jstein91/Apex/Apex rev1.kicad_pcb

## KiCad design Apex rev1.kicad_pcb (2020-07-08)

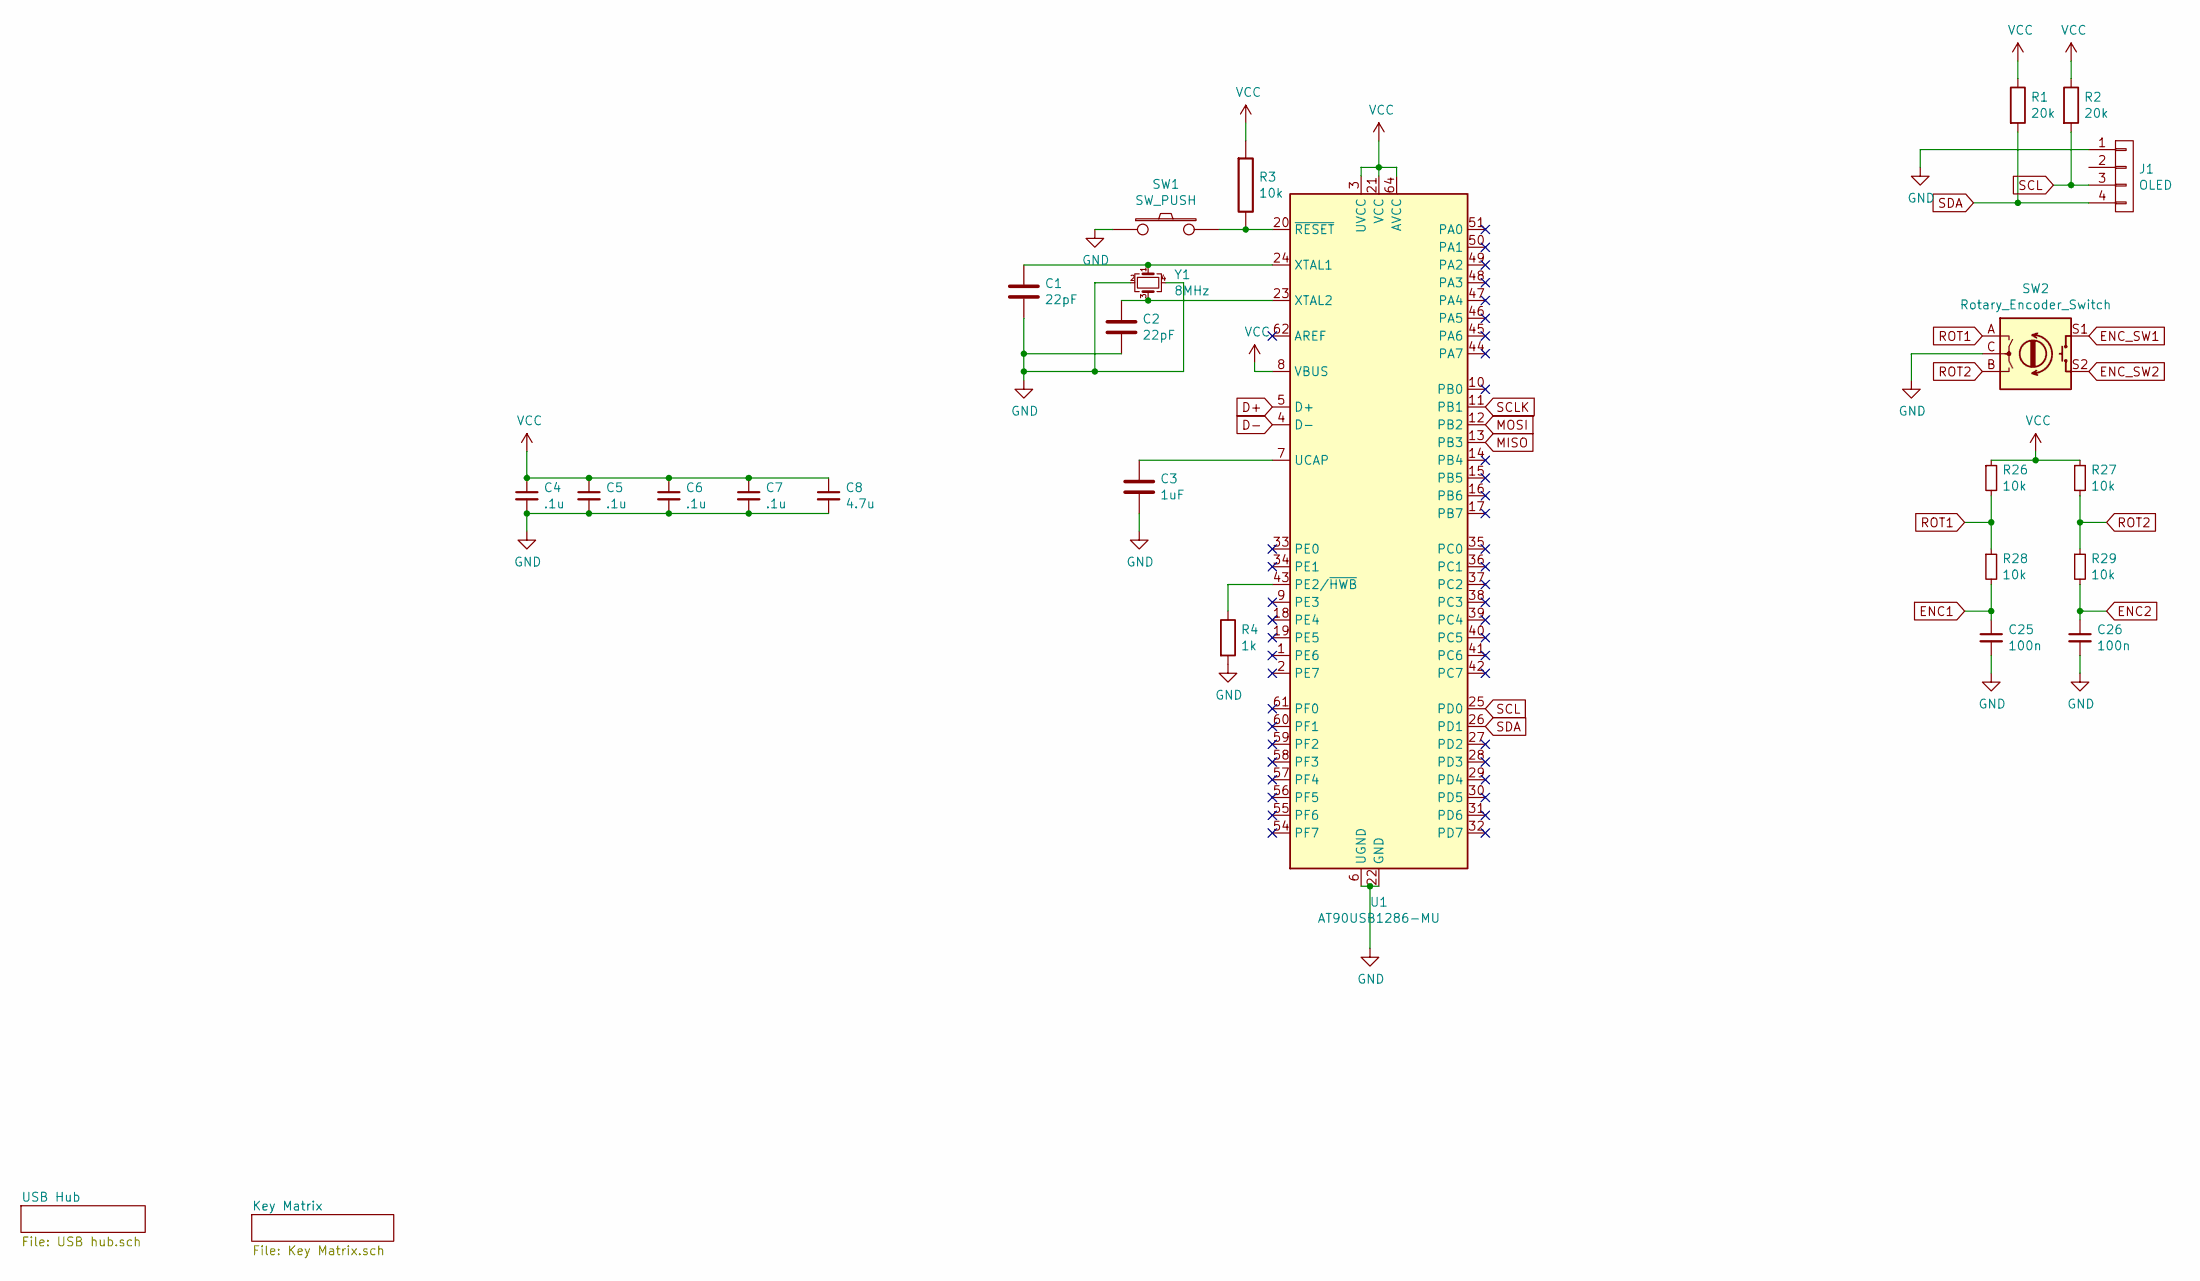
[picture p1: schematic Apex rev1.sch]

Parts:
C1, C2: 22pF; C_0805_2012Metric
C3: 1uF; C_0805_2012Metric
C4, C5, C6, C7: .1u; C_0805_2012Metric
C8: 4.7u; C_0805_2012Metric
C25, C26: 100n; C_0805_2012Metric
J1: OLED; 128X32_I2C_OLED
R1, R2: 20k; R_0603
R3, R26, R27, R28, R29: 10k; R_0603
R4: 1k; R_0603
SW1: SW_PUSH; SKQG-1155865
SW2: Rotary_Encoder_Switch; RotaryEncoder_EC11
U1: AT90USB1286-MU; QFN-64-1EP_9x9mm_P0.5mm_EP7.5x7.5mm
Y1: 8MHz; Crystal_SMD_3225-4Pin_3.2x2.5mm

Connections:
D+: U1.5 (D+); also elsewhere on the board
D-: U1.4 (D-); also elsewhere on the board
ENC1: C25.1, R28.2
ENC2: C26.1, R29.2
ENC_SW1: SW2.S1
ENC_SW2: SW2.S2
GND: C1.2, C2.2, C3.2, C4.2, C5.2, C6.2, C7.2, C8.2, C25.2, C26.2, J1.1, R4.2, SW1.1, SW2.C, U1.6 (UGND), U1.22 (GND), U1.53 (GND), U1.63 (GND), U1.65 (GND), Y1.2, Y1.4; also elsewhere on the board
MISO: U1.13 (PB3)
MOSI: U1.12 (PB2)
unnamed: C1.1, U1.24 (XTAL1), Y1.1
unnamed: C2.1, U1.23 (XTAL2), Y1.3
unnamed: C3.1, U1.7 (UCAP)
unnamed: R3.2, SW1.2, U1.20 (~RESET)
unnamed: R4.1, U1.43 (PE2/~HWB)
ROT1: R26.2, R28.1, SW2.A
ROT2: R27.2, R29.1, SW2.B
SCL: J1.3, R2.2, U1.25 (PD0)
SCLK: U1.11 (PB1)
SDA: J1.4, R1.2, U1.26 (PD1)
VCC: C4.1, C5.1, C6.1, C7.1, C8.1, R1.1, R2.1, R3.1, R26.1, R27.1, U1.3 (UVCC), U1.8 (VBUS), U1.21 (VCC), U1.52 (VCC), U1.64 (AVCC); also elsewhere on the board

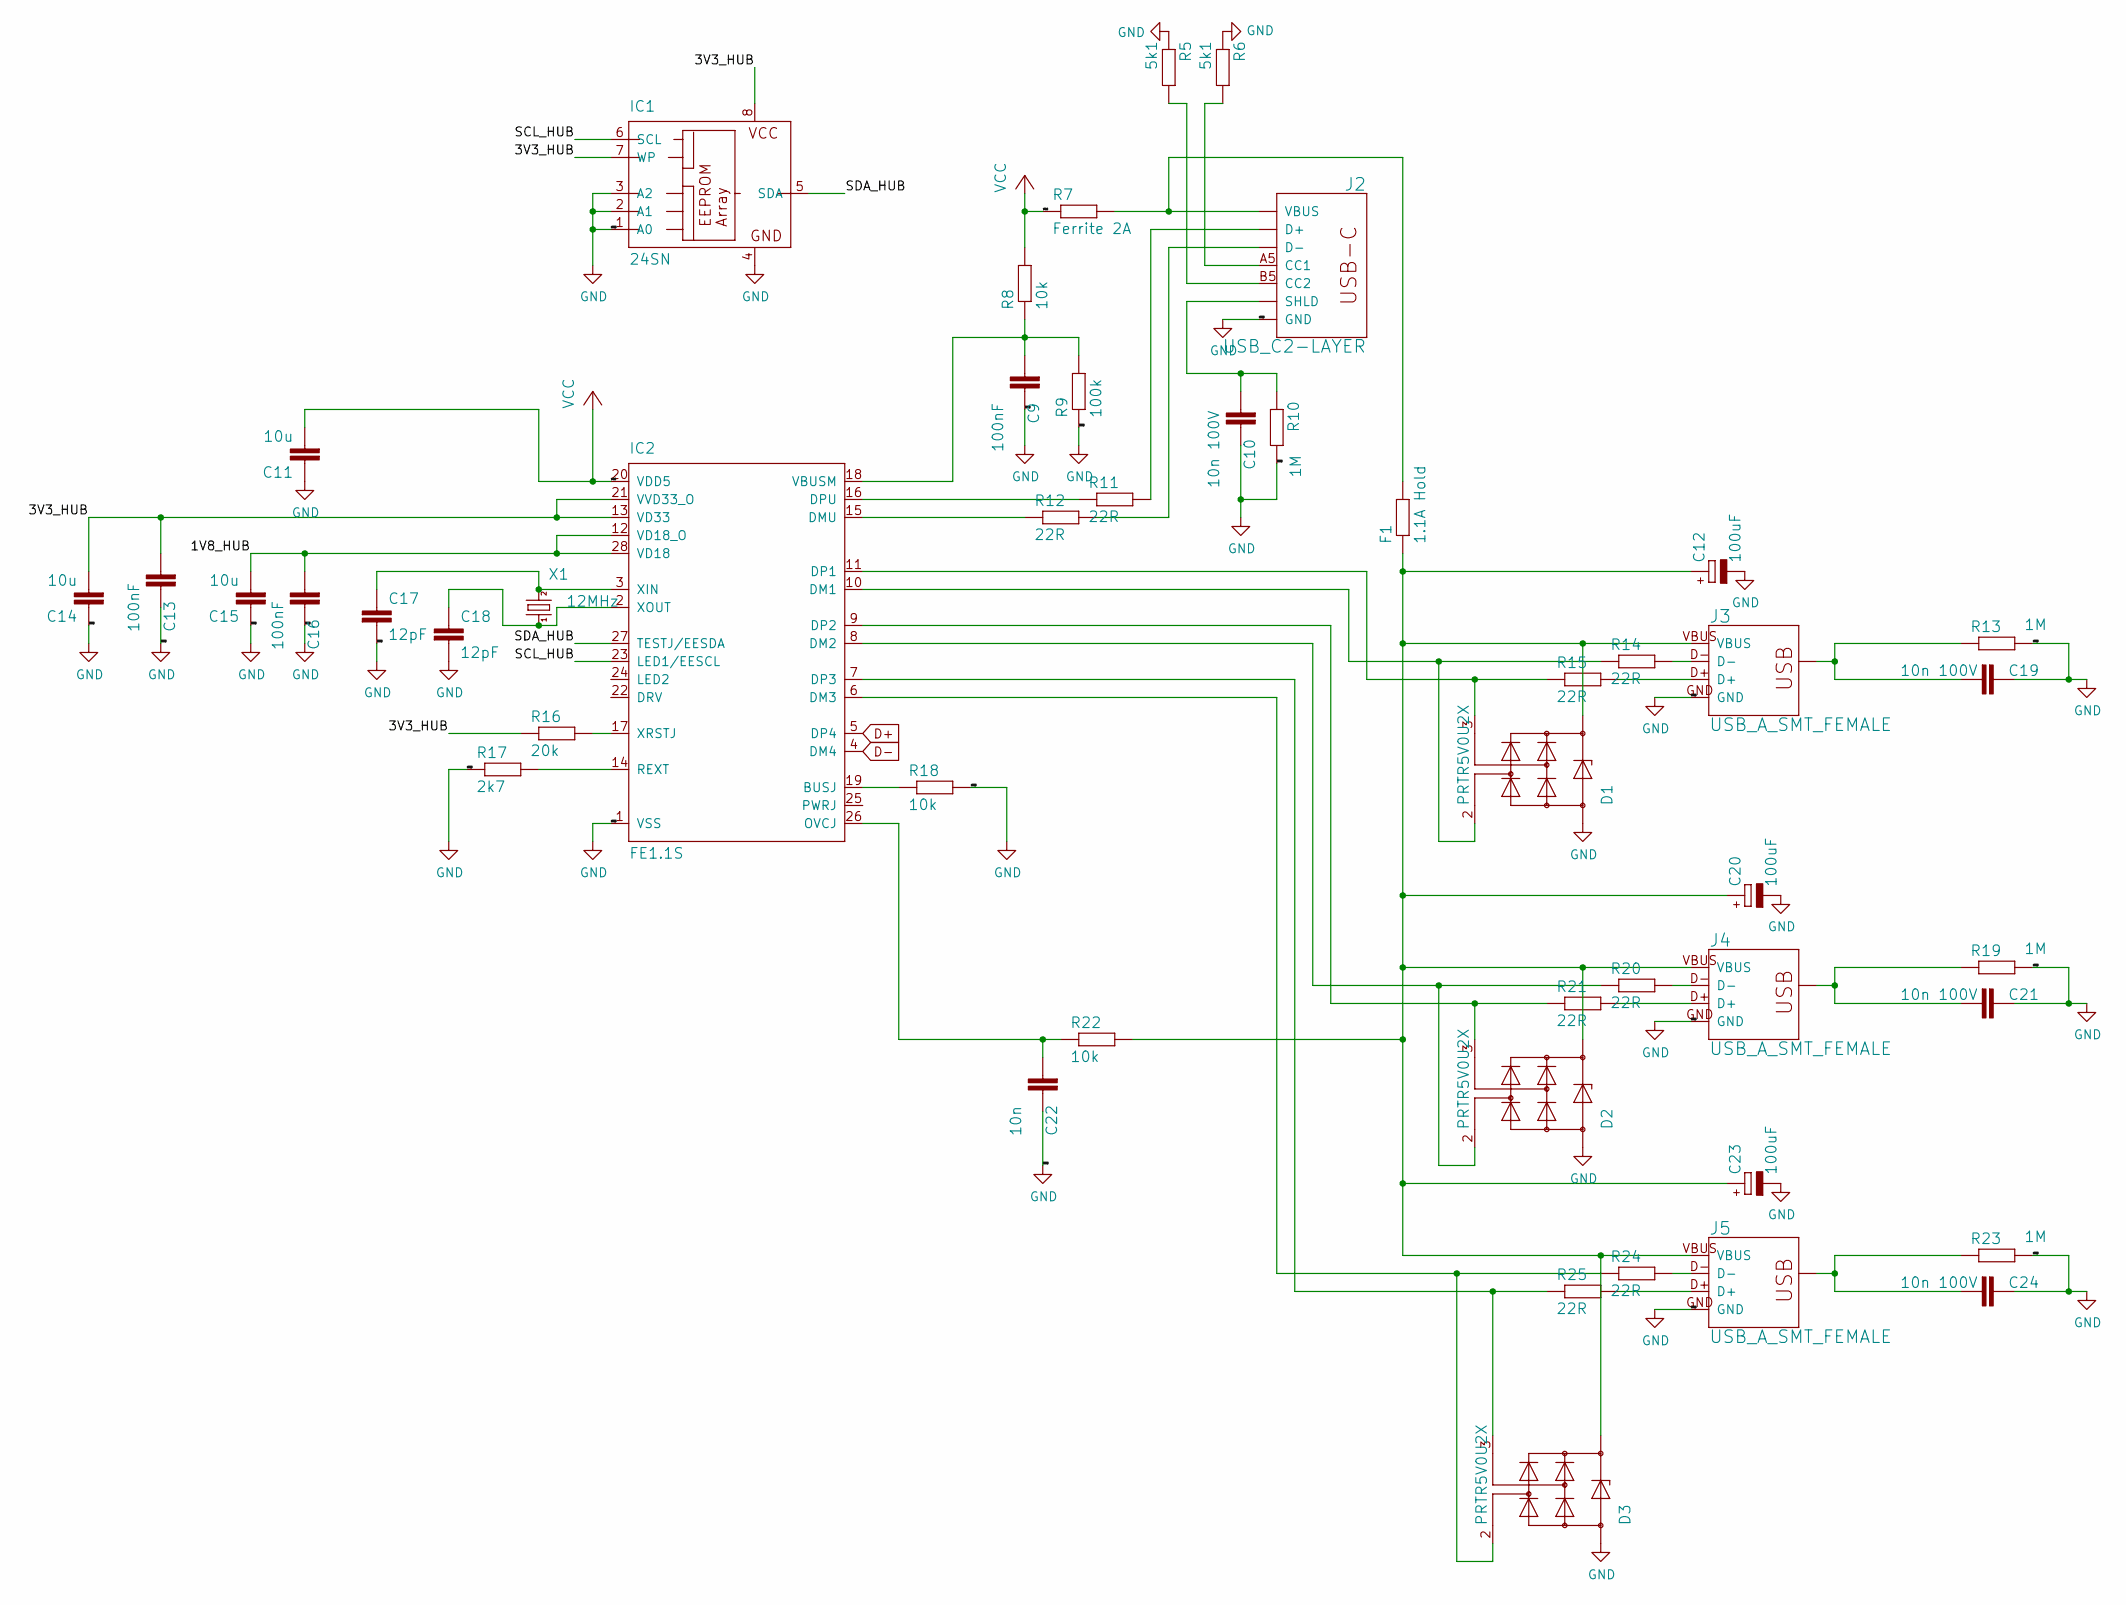
[picture p2: schematic USB hub.sch]

Parts:
C9, C13, C16: 100nF; C_0805_2012Metric; LCSC C14663
C10, C19, C21, C24: 10n 100V; C_0805_2012Metric; LCSC C84709
C11, C14, C15: 10u; C_0805_2012Metric; LCSC C19702
C12, C20, C23: 100uF; CT3528; LCSC C16133
C17, C18: 12pF; C_0805_2012Metric; LCSC C38523
C22: 10n; C_0805_2012Metric; LCSC C57112
D1, D2, D3: PRTR5V0U2X; SOT143; DIGIKEY 1727-3884-1-ND
F1: 1.1A Hold; Fuse_1206_3216Metric; LCSC C70100
IC1: 24SN; SO-08; LCSC C184083
IC2: FE1.1S; SSOP28; LCSC C9359
J2: USB_C2-LAYER; USB-C-16P; DIGIKEY 2073-USB4105-GF-ACT-ND
J3, J4, J5: USB_A_SMT_FEMALE; USB-A-S-SILK-FEMALE; DIGIKEY 609-4946-1-ND
R5, R6: 5k1; R_0603; LCSC C23186
R7: Ferrite 2A; R0805; LCSC C44361
R8, R18, R22: 10k; R_0603; LCSC C25804
R9: 100k; R_0603; LCSC C25803
R10, R13, R19, R23: 1M; R_0603; LCSC C22935
R11, R12, R14, R15, R20, R21, R24, R25: 22R; R_0603; LCSC C23345
R16: 20k; R_0603; LCSC C4184
R17: 2k7; R_0603; LCSC C13167
X1: 12MHz; Crystal_SMD_3225-4Pin_3.2x2.5mm; LCSC C9002

Connections:
/USB Hub/1V8_HUB: C15.2, C16.2, IC2.12 (VD18_O), IC2.28 (VD18)
/USB Hub/3V3_HUB: C13.2, C14.2, IC1.7 (WP), IC1.8 (VCC), IC2.13 (VD33), IC2.21 (VVD33_O), R16.1
/USB Hub/SCL_HUB: IC1.6 (SCL), IC2.23 (LED1/EESCL)
/USB Hub/SDA_HUB: IC1.5 (SDA), IC2.27 (TESTJ/EESDA)
D+: IC2.5 (DP4); also elsewhere on the board
D-: IC2.4 (DM4); also elsewhere on the board
GND: C9.1, C10.1, C11.1, C12.-, C13.1, C14.1, C15.1, C16.1, C17.2, C18.2, C19.1, C20.-, C21.1, C22.1, C23.-, C24.1, D1.1 (GND), D2.1 (GND), D3.1 (GND), IC1.1 (A0), IC1.2 (A1), IC1.3 (A2), IC1.4 (GND), IC2.1 (VSS), J2.GND, J2.GND2 (GND), J3.GND, J4.GND, J5.GND, R5.1, R6.1, R9.1, R10.2, R13.2, R17.1, R18.2, R19.2, R23.2; also elsewhere on the board
unnamed: C9.2, IC2.18 (VBUSM), R8.1, R9.2
unnamed: C10.2, J2.SHLD1 (SHLD), J2.SHLD2 (SHLD), J2.SHLD3 (SHLD), J2.SHLD4 (SHLD), J2.SHLD5 (SHLD), J2.SHLD6 (SHLD), J2.SHLD7 (SHLD), J2.SHLD8 (SHLD), R10.1
unnamed: C12.+, C20.+, C23.+, D1.4 (VCC), D2.4 (VCC), D3.4 (VCC), F1.1, J3.VBUS, J4.VBUS, J5.VBUS, R22.2
unnamed: C17.1, IC2.3 (XIN), X1.3 (2)
unnamed: C18.1, IC2.2 (XOUT), X1.1
unnamed: C19.2, J3.SHLD1 (SHIELD), J3.SHLD2 (SHIELD), R13.1
unnamed: C21.2, J4.SHLD1 (SHIELD), J4.SHLD2 (SHIELD), R19.1
unnamed: C22.2, IC2.26 (OVCJ), R22.1
unnamed: C24.2, J5.SHLD1 (SHIELD), J5.SHLD2 (SHIELD), R23.1
unnamed: D1.2 (IO1), IC2.10 (DM1), R14.1
unnamed: D1.3 (IO2), IC2.11 (DP1), R15.1
unnamed: D2.2 (IO1), IC2.8 (DM2), R20.1
unnamed: D2.3 (IO2), IC2.9 (DP2), R21.1
unnamed: D3.2 (IO1), IC2.6 (DM3), R24.1
unnamed: D3.3 (IO2), IC2.7 (DP3), R25.1
unnamed: F1.2, J2.VBUS1 (VBUS), J2.VBUS2 (VBUS), R7.2
unnamed: IC2.14 (REXT), R17.2
unnamed: IC2.15 (DMU), R12.1
unnamed: IC2.16 (DPU), R11.1
unnamed: IC2.17 (XRSTJ), R16.2
unnamed: IC2.19 (BUSJ), R18.1
unnamed: J2.A5 (CC1), R6.2
unnamed: J2.A6 (D+), J2.B6 (D+), R11.2
unnamed: J2.A7 (D-), J2.B7 (D-), R12.2
unnamed: J2.B5 (CC2), R5.2
unnamed: J3.D+, R15.2
unnamed: J3.D-, R14.2
unnamed: J4.D+, R21.2
unnamed: J4.D-, R20.2
unnamed: J5.D+, R25.2
unnamed: J5.D-, R24.2
VCC: C11.2, IC2.20 (VDD5), R7.1, R8.2; also elsewhere on the board

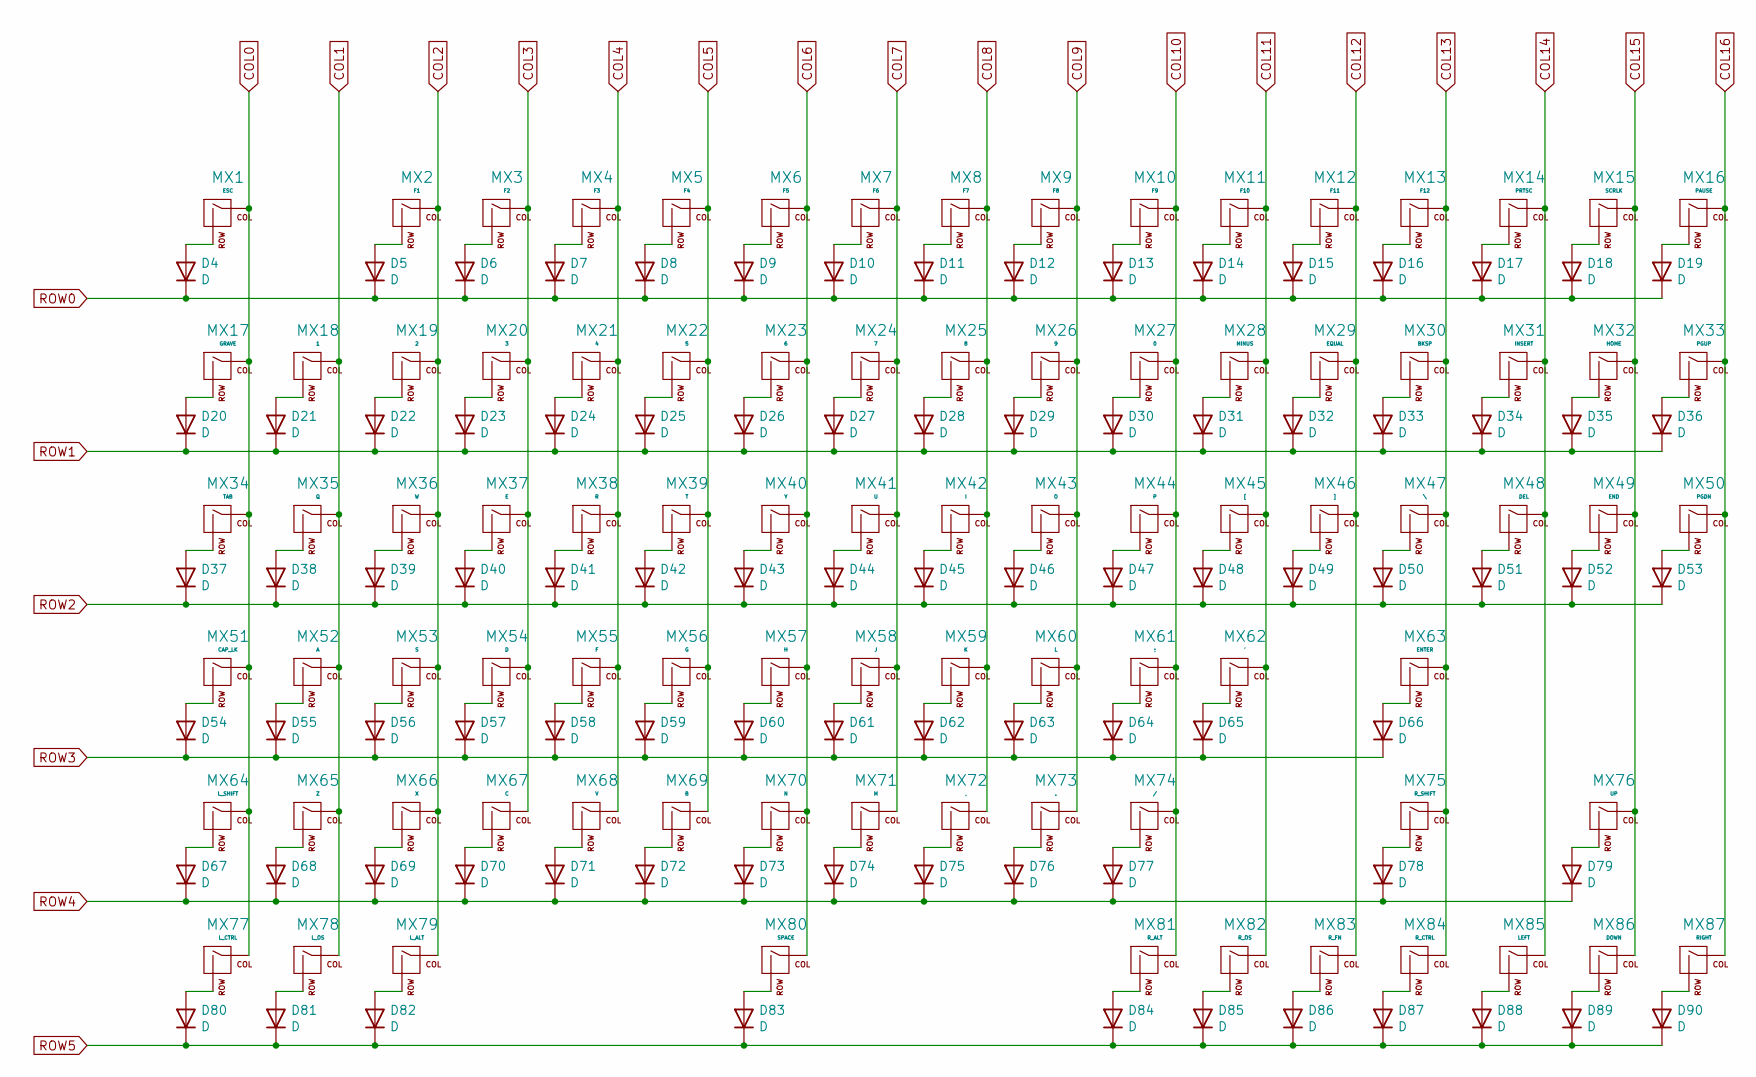
[picture p3: schematic Key Matrix.sch]

Parts:
D4, D5, D6, D7, D8, D9, D10, D11, D12, D13, D14, D15, D16, D17, D18, D19, D20, D21, D22, D23, D24, D25, D26, D27, D28, D29, D30, D31, D32, D33, D34, D35, D36, D37, D38, D39, D40, D41, D42, D43, D44, D45, D46, D47, D48, D49, D50, D51, D52, D53, D54, D55, D56, D57, D58, D59, D60, D61, D62, D63, D64, D65, D66, D67, D68, D69, D70, D71, D72, D73, D74, D75, D76, D77, D78, D79, D80, D81, D82, D83, D84, D85, D86, D87, D88, D89, D90: D; D_SOD-123
MX1: ESC; MXOnly-1U-Hotswap
MX2: F1; MXOnly-1U-Hotswap
MX3: F2; MXOnly-1U-Hotswap
MX4: F3; MXOnly-1U-Hotswap
MX5: F4; MXOnly-1U-Hotswap
MX6: F5; MXOnly-1U-Hotswap
MX7: F6; MXOnly-1U-Hotswap
MX8: F7; MXOnly-1U-Hotswap
MX9: F8; MXOnly-1U-Hotswap
MX10: F9; MXOnly-1U-Hotswap
MX11: F10; MXOnly-1U-Hotswap
MX12: F11; MXOnly-1U-Hotswap
MX13: F12; MXOnly-1U-Hotswap
MX14: PRTSC; MXOnly-1U-Hotswap
MX15: SCRLK; MXOnly-1U-Hotswap
MX16: PAUSE; MXOnly-1U-Hotswap
MX17: GRAVE; MXOnly-1U-Hotswap
MX18: 1; MXOnly-1U-Hotswap
MX19: 2; MXOnly-1U-Hotswap
MX20: 3; MXOnly-1U-Hotswap
MX21: 4; MXOnly-1U-Hotswap
MX22: 5; MXOnly-1U-Hotswap
MX23: 6; MXOnly-1U-Hotswap
MX24: 7; MXOnly-1U-Hotswap
MX25: 8; MXOnly-1U-Hotswap
MX26: 9; MXOnly-1U-Hotswap
MX27: 0; MXOnly-1U-Hotswap
MX28: MINUS; MXOnly-1U-Hotswap
MX29: EQUAL; MXOnly-1U-Hotswap
MX30: BKSP; MXOnly-2U-Hotswap
MX31: INSERT; MXOnly-1U-Hotswap
MX32: HOME; MXOnly-1U-Hotswap
MX33: PGUP; MXOnly-1U-Hotswap
MX34: TAB; MXOnly-1.5U-Hotswap
MX35: Q; MXOnly-1U-Hotswap
MX36: W; MXOnly-1U-Hotswap
MX37: E; MXOnly-1U-Hotswap
MX38: R; MXOnly-1U-Hotswap
MX39: T; MXOnly-1U-Hotswap
MX40: Y; MXOnly-1U-Hotswap
MX41: U; MXOnly-1U-Hotswap
MX42: I; MXOnly-1U-Hotswap
MX43: O; MXOnly-1U-Hotswap
MX44: P; MXOnly-1U-Hotswap
MX45: [; MXOnly-1U-Hotswap
MX46: ]; MXOnly-1U-Hotswap
MX47: \\; MXOnly-1.5U-Hotswap
MX48: DEL; MXOnly-1U-Hotswap
MX49: END; MXOnly-1U-Hotswap
MX50: PGDN; MXOnly-1U-Hotswap
MX51: CAP_LK; MXOnly-1.75U-Hotswap
MX52: A; MXOnly-1U-Hotswap
MX53: S; MXOnly-1U-Hotswap
MX54: D; MXOnly-1U-Hotswap
MX55: F; MXOnly-1U-Hotswap
MX56: G; MXOnly-1U-Hotswap
MX57: H; MXOnly-1U-Hotswap
MX58: J; MXOnly-1U-Hotswap
MX59: K; MXOnly-1U-Hotswap
MX60: L; MXOnly-1U-Hotswap
MX61: ;; MXOnly-1U-Hotswap
MX62: '; MXOnly-1U-Hotswap
MX63: ENTER; MXOnly-2.25U-Hotswap
MX64: L_SHIFT; MXOnly-2.25U-Hotswap
MX65: Z; MXOnly-1U-Hotswap
MX66: X; MXOnly-1U-Hotswap
MX67: C; MXOnly-1U-Hotswap
MX68: V; MXOnly-1U-Hotswap
MX69: B; MXOnly-1U-Hotswap
MX70: N; MXOnly-1U-Hotswap
MX71: M; MXOnly-1U-Hotswap
MX72: ,; MXOnly-1U-Hotswap
MX73: .; MXOnly-1U-Hotswap
MX74: /; MXOnly-1U-Hotswap
MX75: R_SHIFT; MXOnly-2.75U-Hotswap
MX76: UP; MXOnly-1U-Hotswap
MX77: L_CTRL; MXOnly-1.25U-Hotswap
MX78: L_OS; MXOnly-1.25U-Hotswap
MX79: L_ALT; MXOnly-1.25U-Hotswap
MX80: SPACE; MXOnly-6.25U-Hotswap
MX81: R_ALT; MXOnly-1.25U-Hotswap
MX82: R_OS; MXOnly-1.25U-Hotswap
MX83: R_FN; MXOnly-1.25U-Hotswap
MX84: R_CTRL; MXOnly-1.25U-Hotswap
MX85: LEFT; MXOnly-1U-Hotswap
MX86: DOWN; MXOnly-1U-Hotswap
MX87: RIGHT; MXOnly-1U-Hotswap

Connections:
COL0: MX1.1 (COL), MX17.1 (COL), MX34.1 (COL), MX51.1 (COL), MX64.1 (COL), MX77.1 (COL)
COL1: MX18.1 (COL), MX35.1 (COL), MX52.1 (COL), MX65.1 (COL), MX78.1 (COL)
COL2: MX2.1 (COL), MX19.1 (COL), MX36.1 (COL), MX53.1 (COL), MX66.1 (COL), MX79.1 (COL)
COL3: MX3.1 (COL), MX20.1 (COL), MX37.1 (COL), MX54.1 (COL), MX67.1 (COL)
COL4: MX4.1 (COL), MX21.1 (COL), MX38.1 (COL), MX55.1 (COL), MX68.1 (COL)
COL5: MX5.1 (COL), MX22.1 (COL), MX39.1 (COL), MX56.1 (COL), MX69.1 (COL)
COL6: MX6.1 (COL), MX23.1 (COL), MX40.1 (COL), MX57.1 (COL), MX70.1 (COL), MX80.1 (COL)
COL7: MX7.1 (COL), MX24.1 (COL), MX41.1 (COL), MX58.1 (COL), MX71.1 (COL)
COL8: MX8.1 (COL), MX25.1 (COL), MX42.1 (COL), MX59.1 (COL), MX72.1 (COL)
COL9: MX9.1 (COL), MX26.1 (COL), MX43.1 (COL), MX60.1 (COL), MX73.1 (COL)
COL10: MX10.1 (COL), MX27.1 (COL), MX44.1 (COL), MX61.1 (COL), MX74.1 (COL), MX81.1 (COL)
COL11: MX11.1 (COL), MX28.1 (COL), MX45.1 (COL), MX62.1 (COL), MX82.1 (COL)
COL12: MX12.1 (COL), MX29.1 (COL), MX46.1 (COL), MX83.1 (COL)
COL13: MX13.1 (COL), MX30.1 (COL), MX47.1 (COL), MX63.1 (COL), MX75.1 (COL), MX84.1 (COL)
COL14: MX14.1 (COL), MX31.1 (COL), MX48.1 (COL), MX85.1 (COL)
COL15: MX15.1 (COL), MX32.1 (COL), MX49.1 (COL), MX76.1 (COL), MX86.1 (COL)
COL16: MX16.1 (COL), MX33.1 (COL), MX50.1 (COL), MX87.1 (COL)
unnamed: D4.2 (A), MX1.2 (ROW)
unnamed: D5.2 (A), MX2.2 (ROW)
unnamed: D6.2 (A), MX3.2 (ROW)
unnamed: D7.2 (A), MX4.2 (ROW)
unnamed: D8.2 (A), MX5.2 (ROW)
unnamed: D9.2 (A), MX6.2 (ROW)
unnamed: D10.2 (A), MX7.2 (ROW)
unnamed: D11.2 (A), MX8.2 (ROW)
unnamed: D12.2 (A), MX9.2 (ROW)
unnamed: D13.2 (A), MX10.2 (ROW)
unnamed: D14.2 (A), MX11.2 (ROW)
unnamed: D15.2 (A), MX12.2 (ROW)
unnamed: D16.2 (A), MX13.2 (ROW)
unnamed: D17.2 (A), MX14.2 (ROW)
unnamed: D18.2 (A), MX15.2 (ROW)
unnamed: D19.2 (A), MX16.2 (ROW)
unnamed: D20.2 (A), MX17.2 (ROW)
unnamed: D21.2 (A), MX18.2 (ROW)
unnamed: D22.2 (A), MX19.2 (ROW)
unnamed: D23.2 (A), MX20.2 (ROW)
unnamed: D24.2 (A), MX21.2 (ROW)
unnamed: D25.2 (A), MX22.2 (ROW)
unnamed: D26.2 (A), MX23.2 (ROW)
unnamed: D27.2 (A), MX24.2 (ROW)
unnamed: D28.2 (A), MX25.2 (ROW)
unnamed: D29.2 (A), MX26.2 (ROW)
unnamed: D30.2 (A), MX27.2 (ROW)
unnamed: D31.2 (A), MX28.2 (ROW)
unnamed: D32.2 (A), MX29.2 (ROW)
unnamed: D33.2 (A), MX30.2 (ROW)
unnamed: D34.2 (A), MX31.2 (ROW)
unnamed: D35.2 (A), MX32.2 (ROW)
unnamed: D36.2 (A), MX33.2 (ROW)
unnamed: D37.2 (A), MX34.2 (ROW)
unnamed: D38.2 (A), MX35.2 (ROW)
unnamed: D39.2 (A), MX36.2 (ROW)
unnamed: D40.2 (A), MX37.2 (ROW)
unnamed: D41.2 (A), MX38.2 (ROW)
unnamed: D42.2 (A), MX39.2 (ROW)
unnamed: D43.2 (A), MX40.2 (ROW)
unnamed: D44.2 (A), MX41.2 (ROW)
unnamed: D45.2 (A), MX42.2 (ROW)
unnamed: D46.2 (A), MX43.2 (ROW)
unnamed: D47.2 (A), MX44.2 (ROW)
unnamed: D48.2 (A), MX45.2 (ROW)
unnamed: D49.2 (A), MX46.2 (ROW)
unnamed: D50.2 (A), MX47.2 (ROW)
unnamed: D51.2 (A), MX48.2 (ROW)
unnamed: D52.2 (A), MX49.2 (ROW)
unnamed: D53.2 (A), MX50.2 (ROW)
unnamed: D54.2 (A), MX51.2 (ROW)
unnamed: D55.2 (A), MX52.2 (ROW)
unnamed: D56.2 (A), MX53.2 (ROW)
unnamed: D57.2 (A), MX54.2 (ROW)
unnamed: D58.2 (A), MX55.2 (ROW)
unnamed: D59.2 (A), MX56.2 (ROW)
unnamed: D60.2 (A), MX57.2 (ROW)
unnamed: D61.2 (A), MX58.2 (ROW)
unnamed: D62.2 (A), MX59.2 (ROW)
unnamed: D63.2 (A), MX60.2 (ROW)
unnamed: D64.2 (A), MX61.2 (ROW)
unnamed: D65.2 (A), MX62.2 (ROW)
unnamed: D66.2 (A), MX63.2 (ROW)
unnamed: D67.2 (A), MX64.2 (ROW)
unnamed: D68.2 (A), MX65.2 (ROW)
unnamed: D69.2 (A), MX66.2 (ROW)
unnamed: D70.2 (A), MX67.2 (ROW)
unnamed: D71.2 (A), MX68.2 (ROW)
unnamed: D72.2 (A), MX69.2 (ROW)
unnamed: D73.2 (A), MX70.2 (ROW)
unnamed: D74.2 (A), MX71.2 (ROW)
unnamed: D75.2 (A), MX72.2 (ROW)
unnamed: D76.2 (A), MX73.2 (ROW)
unnamed: D77.2 (A), MX74.2 (ROW)
unnamed: D78.2 (A), MX75.2 (ROW)
unnamed: D79.2 (A), MX76.2 (ROW)
unnamed: D80.2 (A), MX77.2 (ROW)
unnamed: D81.2 (A), MX78.2 (ROW)
unnamed: D82.2 (A), MX79.2 (ROW)
unnamed: D83.2 (A), MX80.2 (ROW)
unnamed: D84.2 (A), MX81.2 (ROW)
unnamed: D85.2 (A), MX82.2 (ROW)
unnamed: D86.2 (A), MX83.2 (ROW)
unnamed: D87.2 (A), MX84.2 (ROW)
unnamed: D88.2 (A), MX85.2 (ROW)
unnamed: D89.2 (A), MX86.2 (ROW)
unnamed: D90.2 (A), MX87.2 (ROW)
ROW0: D4.1 (K), D5.1 (K), D6.1 (K), D7.1 (K), D8.1 (K), D9.1 (K), D10.1 (K), D11.1 (K), D12.1 (K), D13.1 (K), D14.1 (K), D15.1 (K), D16.1 (K), D17.1 (K), D18.1 (K), D19.1 (K)
ROW1: D20.1 (K), D21.1 (K), D22.1 (K), D23.1 (K), D24.1 (K), D25.1 (K), D26.1 (K), D27.1 (K), D28.1 (K), D29.1 (K), D30.1 (K), D31.1 (K), D32.1 (K), D33.1 (K), D34.1 (K), D35.1 (K), D36.1 (K)
ROW2: D37.1 (K), D38.1 (K), D39.1 (K), D40.1 (K), D41.1 (K), D42.1 (K), D43.1 (K), D44.1 (K), D45.1 (K), D46.1 (K), D47.1 (K), D48.1 (K), D49.1 (K), D50.1 (K), D51.1 (K), D52.1 (K), D53.1 (K)
ROW3: D54.1 (K), D55.1 (K), D56.1 (K), D57.1 (K), D58.1 (K), D59.1 (K), D60.1 (K), D61.1 (K), D62.1 (K), D63.1 (K), D64.1 (K), D65.1 (K), D66.1 (K)
ROW4: D67.1 (K), D68.1 (K), D69.1 (K), D70.1 (K), D71.1 (K), D72.1 (K), D73.1 (K), D74.1 (K), D75.1 (K), D76.1 (K), D77.1 (K), D78.1 (K), D79.1 (K)
ROW5: D80.1 (K), D81.1 (K), D82.1 (K), D83.1 (K), D84.1 (K), D85.1 (K), D86.1 (K), D87.1 (K), D88.1 (K), D89.1 (K), D90.1 (K)

Board: 2 copper layers, 245 parts (0 on the bottom side), 160 nets, no tracks yet.
