jstein91/Apex/hub_keyboard/hub_keyboard.kicad_pcb

## KiCad design hub_keyboard/hub_keyboard.kicad_pcb (2020-07-06)

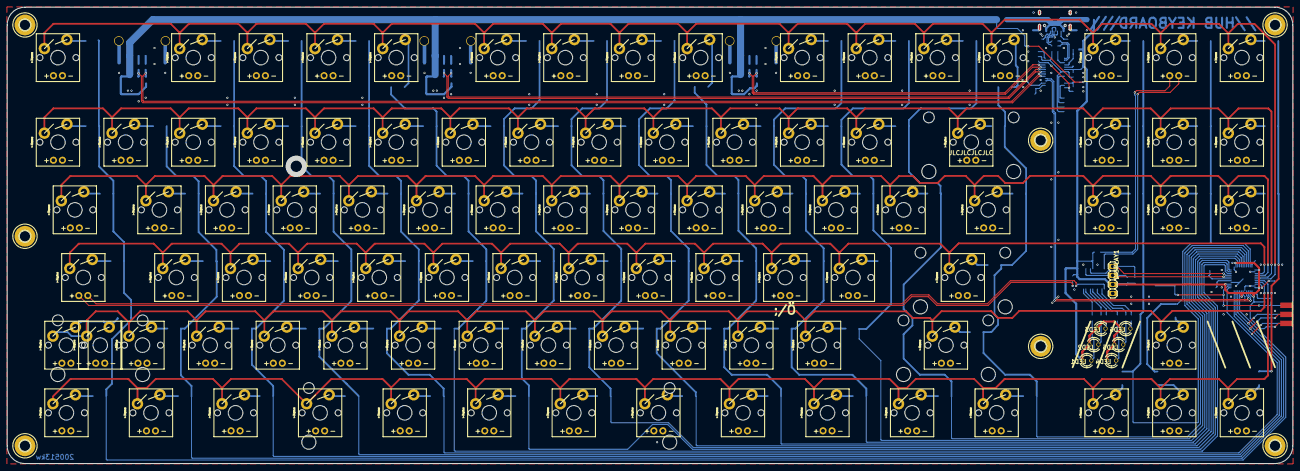
[picture p4: board hub_keyboard.kicad_pcb from above]

Board: 2 copper layers, 362.0 x 128.5 mm, 280 parts (0 on the bottom side), 178 nets.

Parts:
,/Ä1: MECHANICAL-KEYBOARD1U; CHERRY-MX-LED-1U
-/ß1: MECHANICAL-KEYBOARD1U; CHERRY-MX-LED-1U
.1: MECHANICAL-KEYBOARD1U; CHERRY-MX-LED-1U
//-1: MECHANICAL-KEYBOARD1U; CHERRY-MX-LED-1U
</,1: MECHANICAL-KEYBOARD1U; CHERRY-MX-LED-1U
<>1: MECHANICAL-KEYBOARD1U; CHERRY-MX-LED-1U
=/´1: MECHANICAL-KEYBOARD1U; CHERRY-MX-LED-1U
>/.1: MECHANICAL-KEYBOARD1U; CHERRY-MX-LED-1U
@HOLE0, @HOLE1, @HOLE2, @HOLE3, @HOLE4, @HOLE5, @HOLE6: (no value)
A1: MECHANICAL-KEYBOARD1U; CHERRY-MX-LED-1U
B1: MECHANICAL-KEYBOARD1U; CHERRY-MX-LED-1U
BACKSPACE1: MECHANICAL-KEYBOARD2U; CHERRY-MX-LED-1X2U
C1, C4, C6, C8: 10n 100V; C0603
C2, C10, C15, C19: 100nF; C0603
C3, C5, C7: 100uF; CT3528
C9, C16, C17, C18: 12pF; C0603
C11, C12, C13: 10u; C0603
C14: 10n; C0603
C20: 1u; C0603
C21: MECHANICAL-KEYBOARD1U; CHERRY-MX-LED-1U
CAPSLOCK1: MECHANICAL-KEYBOARD1.75U; CHERRY-MX-LED-1.75U
D1, D2, D3, D4, D5, D6, D7, D8, D9, D10, D11, D12, D13, D15, D17, D19, D20, D21, D22, D23, D24, D25, D26, D27, D28, D29, D30, D31, D32, D33, D34, D35, D36, D37, D38, D39, D40, D41, D42, D43, D44, D45, D46, D47, D48, D49, D50, D51, D52, D53, D54, D55, D56, D57, D58, D59, D60, D61, D62, D63, D64, D65, D66, D67, D68, D69, D70, D71, D72, D73, D74, D75, D76, D77, D78, D79, D80, D81, D82, D83, D84, D85, D86, D87, D88, D89, D90, D91, D92, D93, D94, D95: 1N4148; SOD123
D14, D16, D18: PRTR5V0U2X; SOT143
D96: MECHANICAL-KEYBOARD1U; CHERRY-MX-LED-1U
D-ARR1: MECHANICAL-KEYBOARD1U; CHERRY-MX-LED-1U
DELETE1: MECHANICAL-KEYBOARD1U; CHERRY-MX-LED-1U
DISPLAY1: I2C_OLED_128X32; 128X32_I2C_OLED
DOWN1: MECHANICAL-KEYBOARD1U; CHERRY-MX-LED-1U
E1: MECHANICAL-KEYBOARD1U; CHERRY-MX-LED-1U
END1: MECHANICAL-KEYBOARD1U; CHERRY-MX-LED-1U
ESC1: MECHANICAL-KEYBOARD1U; CHERRY-MX-LED-1U
F1: 1.1A Hold; R1210
F2: MECHANICAL-KEYBOARD1U; CHERRY-MX-LED-1U
F_1, F_2, F_3, F_4, F_5, F_6, F_7, F_8, F_9, F_10, F_11, F_12: MECHANICAL-KEYBOARD1U; CHERRY-MX-LED-1U
G1: MECHANICAL-KEYBOARD1U; CHERRY-MX-LED-1U
H1, H2, H3, H4, H5, H6, H7: MOUNT-PAD-ROUND3.2; 3,2-PAD
H8: MECHANICAL-KEYBOARD1U; CHERRY-MX-LED-1U
HOME1: MECHANICAL-KEYBOARD1U; CHERRY-MX-LED-1U
I1: MECHANICAL-KEYBOARD1U; CHERRY-MX-LED-1U
IC1: FE1.1S; SSOP28
IC2: 24SN; SO-08
IC3: PCF8574APWR; SSOP20
IC4: ATMEGA32U4-MU; QFN44G-0.5-7X7MM
INSERT1: MECHANICAL-KEYBOARD1U; CHERRY-MX-LED-1U
ISP1: AVR-ISP-6-EDGE; 6PAD_ISP
J1, J2, J3: USB_A_SMT_FEMALE; USB-A-S-SILK-FEMALE
J4: USB_C2-LAYER; USB-C-16P
J5: MECHANICAL-KEYBOARD1U; CHERRY-MX-LED-1U
K1: MECHANICAL-KEYBOARD1U; CHERRY-MX-LED-1U
L1: MECHANICAL-KEYBOARD1U; CHERRY-MX-LED-1U
L-ALT1: MECHANICAL-KEYBOARD1.25U; CHERRY-MX-LED-1.25U
L-CTRL1: MECHANICAL-KEYBOARD1.25U; CHERRY-MX-LED-1.25U
L-OS1: MECHANICAL-KEYBOARD1.25U; CHERRY-MX-LED-1.25U
L-SHIFT1: MECHANICAL-KEYBOARD1.25U; CHERRY-MX-LED-1.25U
L-SHIFT2: MECHANICAL-KEYBOARD2.25U; CHERRY-MX-LED-1X2.25
LED1, LED2, LED3, LED4, LED5, LED6: LED3MM
LS1, LS2: MECHANICAL-KEYBOARD1.25U; CHERRY-MX-LED-1.25U
L_ARR1: MECHANICAL-KEYBOARD1U; CHERRY-MX-LED-1U
M1: MECHANICAL-KEYBOARD1U; CHERRY-MX-LED-1U
MENU1: MECHANICAL-KEYBOARD1.25U; CHERRY-MX-LED-1.25U
N1: MECHANICAL-KEYBOARD1U; CHERRY-MX-LED-1U
O1: MECHANICAL-KEYBOARD1U; CHERRY-MX-LED-1U
P1: MECHANICAL-KEYBOARD1U; CHERRY-MX-LED-1U
PAUSE1: MECHANICAL-KEYBOARD1U; CHERRY-MX-LED-1U
PRINT1: MECHANICAL-KEYBOARD1U; CHERRY-MX-LED-1U
Q1: MECHANICAL-KEYBOARD1U; CHERRY-MX-LED-1U
R1: 2k7; R0603
R2, R6: 5k1; R0603
R3, R4, R11, R12, R14, R15, R17, R18: 22R; R0603
R5, R24, R25: 20k; R0603
R7, R20, R21, R33: 10k; R0603
R8, R10, R13, R16: 1M; R0603
R9: Ferrite 2A; R0805
R19: 100k; R0603
R22, R23, R26, R27, R28, R29, R30, R31, R32: 1k; R0603
R34: MECHANICAL-KEYBOARD1U; CHERRY-MX-LED-1U
R-ALT1: MECHANICAL-KEYBOARD1.25U; CHERRY-MX-LED-1.25U
R-CTRL1: MECHANICAL-KEYBOARD1.25U; CHERRY-MX-LED-1.25U
R-OS1: MECHANICAL-KEYBOARD1.25U; CHERRY-MX-LED-1.25U
R-SHIFT1: MECHANICAL-KEYBOARD2.75U; CHERRY-MX-LED-1X2.75
RESET1: MOMENTARY-SWITCH-SPST-SMD-5.2-REDUNDANT; TACTILE_SWITCH_SMD_5.2MM
RETURN1: MECHANICAL-KEYBOARD2.25U; CHERRY-MX-LED-1X2.25
RS1, RS2: MECHANICAL-KEYBOARD1.25U; CHERRY-MX-LED-1.25U
R_ARR1: MECHANICAL-KEYBOARD1U; CHERRY-MX-LED-1U
S1: STABILIZER-1X2U; STABILIZER_1X2U
S2, S3: STABILIZER-1X2.25U; STABILIZER_1X2.25U
S4: STABILIZER-1X2.75U; STABILIZER_1X2.75U
S5: STABILIZER-1X6.25U; STABILIZER_1X6.25U
S6: MECHANICAL-KEYBOARD1U; CHERRY-MX-LED-1U
SCROLL1: MECHANICAL-KEYBOARD1U; CHERRY-MX-LED-1U
SPACE1: MECHANICAL-KEYBOARD6.25U; CHERRY-MX-LED-1X6.25
T1: MECHANICAL-KEYBOARD1U; CHERRY-MX-LED-1U
TAB1: MECHANICAL-KEYBOARD1.5U; CHERRY-MX-LED-1.5U
U1: MECHANICAL-KEYBOARD1U; CHERRY-MX-LED-1U
UNK0, UNK1, UNK2, UNK3, UNK4, UNK5, UNK6, UNK7, UNK8, UNK9: MECHANICAL-KEYBOARD1U; CHERRY-MX-LED-1U
UP1: MECHANICAL-KEYBOARD1U; CHERRY-MX-LED-1U
U_ARR1: MECHANICAL-KEYBOARD1U; CHERRY-MX-LED-1U
V1: MECHANICAL-KEYBOARD1U; CHERRY-MX-LED-1U
W1: MECHANICAL-KEYBOARD1U; CHERRY-MX-LED-1U
X1: 12MHz; 3.2X2.5_KX-7
X2: 16MHz; 3.2X2.5_KX-7
X3: MECHANICAL-KEYBOARD1U; CHERRY-MX-LED-1U
Y/Z1: MECHANICAL-KEYBOARD1U; CHERRY-MX-LED-1U
Z/Y1: MECHANICAL-KEYBOARD1U; CHERRY-MX-LED-1U
[/Ü1: MECHANICAL-KEYBOARD1U; CHERRY-MX-LED-1U
\\/#1: MECHANICAL-KEYBOARD1.5U; CHERRY-MX-LED-1.5U
]/+1: MECHANICAL-KEYBOARD1U; CHERRY-MX-LED-1U
`/^1: MECHANICAL-KEYBOARD1U; CHERRY-MX-LED-1U

Connections:
/hub_keyboard_2/1V8_HUB: C11.2, C15.2, IC1.12, IC1.28
/hub_keyboard_2/3V3_HUB: C10.2, C13.2, IC1.13, IC1.21, IC2.7, IC2.8, R5.1
/hub_keyboard_2/RST: IC4.13, ISP1.RST, R33.2, RESET1.1, RESET1.2
/hub_keyboard_2/SCL: DISPLAY1.3, IC3.2, IC4.18, R24.2
/hub_keyboard_2/SCL_HUB: IC1.23, IC2.6
/hub_keyboard_2/SDA: DISPLAY1.4, IC3.4, IC4.19, R25.2
/hub_keyboard_2/SDA_HUB: IC1.27, IC2.5
C1: D1.C, D20.C, D37.C, D54.C, D67.C, D81.C, IC4.8
C2/SCK: D21.C, D38.C, D55.C, D68.C, D82.C, IC4.9, ISP1.SCK
C3/MOSI: D2.C, D22.C, D39.C, D56.C, D69.C, D83.C, IC4.10, ISP1.MOSI
C4/MISO: D3.C, D23.C, D40.C, D57.C, D70.C, D84.C, IC4.11, ISP1.MISO
C5: D4.C, D24.C, D41.C, D58.C, D71.C, D85.C, IC4.12
C6: D15.C, D25.C, D42.C, D59.C, D72.C, IC4.20
C7: D5.C, D26.C, D43.C, D60.C, D73.C, D86.C, IC4.21
C8: D6.C, D27.C, D44.C, D61.C, D74.C, D87.C, IC4.22
C9: D7.C, D28.C, D45.C, D62.C, D75.C, D88.C, IC4.25
C10: D17.C, D29.C, D46.C, D63.C, D76.C, D89.C, IC4.26
C11: D8.C, D30.C, D47.C, D64.C, D77.C, D90.C, IC4.27
C12: D9.C, D31.C, D48.C, D65.C, D78.C, IC4.28
C13: D10.C, D32.C, D49.C, D91.C, IC4.29
C14: D19.C, D33.C, D50.C, D66.C, D79.C, D92.C, IC4.30
C15: D11.C, D34.C, D51.C, D93.C, IC4.31
C16: D12.C, D35.C, D52.C, D80.C, D94.C, IC4.32
C17: D13.C, D36.C, D53.C, D95.C, IC4.1
CL_LED_A: CAPSLOCK1.A, R22.1
CL_LED_C: CAPSLOCK1.K, IC3.11
GND: C1.1, C2.1, C3.-, C4.1, C5.-, C6.1, C7.-, C8.1, C9.2, C10.1, C11.1, C12.1, C13.1, C14.1, C15.1, C16.2, C17.2, C18.2, C19.1, C20.1, D14.1, D16.1, D18.1, DISPLAY1.1, IC1.1, IC2.1, IC2.2, IC2.3, IC2.4, IC3.6, IC3.7, IC3.9, IC3.15, IC4.5, IC4.15, IC4.23, IC4.35, IC4.43, IC4.TAB, ISP1.GND, J1.GND, J2.GND, J3.GND, J4.GND, J4.GND2, R1.1, R2.1, R6.1, R8.2, R10.2, R13.2, R16.2, R19.1, R20.2, R26.1, RESET1.3, RESET1.4
unnamed: ,/Ä1.S2, D65.A
unnamed: -/ß1.S2, D31.A
unnamed: .1.S2, D64.A
unnamed: //-1.S2, D78.A
unnamed: </,1.S2, D76.A
unnamed: <>1.S2, D68.A
unnamed: =/´1.S2, D32.A
unnamed: >/.1.S2, D77.A
unnamed: A1.S2, D55.A
unnamed: B1.S2, D73.A
unnamed: BACKSPACE1.S2, D33.A
unnamed: C1.2, J4.SHLD1, J4.SHLD2, J4.SHLD3, J4.SHLD4, J4.SHLD5, J4.SHLD6, J4.SHLD7, J4.SHLD8, R8.1
unnamed: C2.2, IC1.18, R7.1, R19.2
unnamed: C3.+, C5.+, C7.+, D14.4, D16.4, D18.4, F1.1, J1.VBUS, J2.VBUS, J3.VBUS, R21.2
unnamed: C4.2, J1.SHLD1, J1.SHLD2, R10.1
unnamed: C6.2, J2.SHLD1, J2.SHLD2, R13.1
unnamed: C8.2, J3.SHLD1, J3.SHLD2, R16.1
unnamed: C9.1, IC1.3, X1.3
unnamed: C14.2, IC1.26, R21.1
unnamed: C16.1, IC1.2, X1.1
unnamed: C17.1, IC4.17, X2.3
unnamed: C18.1, IC4.16, X2.1
unnamed: C19.2, IC4.42
unnamed: C20.2, IC4.6
unnamed: C21.S2, D71.A
unnamed: CAPSLOCK1.S2, D54.A
unnamed: D1.A, ESC1.S2
unnamed: D2.A, F_1.S2
unnamed: D3.A, F_2.S2
unnamed: D4.A, F_3.S2
unnamed: D5.A, F_5.S2
unnamed: D6.A, F_6.S2
unnamed: D7.A, F_7.S2
unnamed: D8.A, F_9.S2
unnamed: D9.A, F_10.S2
unnamed: D10.A, F_11.S2
unnamed: D11.A, PRINT1.S2
unnamed: D12.A, SCROLL1.S2
unnamed: D13.A, PAUSE1.S2
unnamed: D14.2, IC1.6, R11.1
unnamed: D14.3, IC1.7, R12.1
unnamed: D15.A, F_4.S2
unnamed: D16.2, IC1.8, R14.1
unnamed: D16.3, IC1.9, R15.1
unnamed: D17.A, F_8.S2
unnamed: D18.2, IC1.10, R17.1
unnamed: D18.3, IC1.11, R18.1
unnamed: D19.A, F_12.S2
unnamed: D20.A, `/^1.S2
unnamed: D21.A, UNK1.S2
unnamed: D22.A, UNK2.S2
unnamed: D23.A, UNK3.S2
unnamed: D24.A, UNK4.S2
unnamed: D25.A, UNK5.S2
unnamed: D26.A, UNK6.S2
unnamed: D27.A, UNK7.S2
unnamed: D28.A, UNK8.S2
unnamed: D29.A, UNK9.S2
unnamed: D30.A, UNK0.S2
unnamed: D34.A, INSERT1.S2
unnamed: D35.A, HOME1.S2
unnamed: D36.A, UP1.S2
unnamed: D37.A, TAB1.S2
unnamed: D38.A, Q1.S2
unnamed: D39.A, W1.S2
unnamed: D40.A, E1.S2
unnamed: D41.A, R34.S2
unnamed: D42.A, T1.S2
unnamed: D43.A, Z/Y1.S2
unnamed: D44.A, U1.S2
unnamed: D45.A, I1.S2
unnamed: D46.A, O1.S2
unnamed: D47.A, P1.S2
unnamed: D48.A, [/Ü1.S2
unnamed: D49.A, ]/+1.S2
unnamed: D50.A, \\/#1.S2
unnamed: D51.A, DELETE1.S2
unnamed: D52.A, END1.S2
unnamed: D53.A, DOWN1.S2
unnamed: D56.A, S6.S2
unnamed: D57.A, D96.S2
unnamed: D58.A, F2.S2
unnamed: D59.A, G1.S2
unnamed: D60.A, H8.S2
unnamed: D61.A, J5.S2
unnamed: D62.A, K1.S2
unnamed: D63.A, L1.S2
unnamed: D66.A, RETURN1.S2
unnamed: D67.A, L-SHIFT1.S2, L-SHIFT2.S2
unnamed: D69.A, Y/Z1.S2
unnamed: D70.A, X3.S2
unnamed: D72.A, V1.S2
unnamed: D74.A, N1.S2
unnamed: D75.A, M1.S2
unnamed: D79.A, R-SHIFT1.S2
unnamed: D80.A, U_ARR1.S2
unnamed: D81.A, L-CTRL1.S2
unnamed: D82.A, L-OS1.S2
unnamed: D83.A, L-ALT1.S2
unnamed: D84.A, LS1.S2
unnamed: D85.A, LS2.S2
unnamed: D86.A, SPACE1.S2
unnamed: D87.A, RS1.S2
unnamed: D88.A, RS2.S2
unnamed: D89.A, R-ALT1.S2
unnamed: D90.A, R-OS1.S2
unnamed: D91.A, MENU1.S2
unnamed: D92.A, R-CTRL1.S2
unnamed: D93.A, L_ARR1.S2
unnamed: D95.A, R_ARR1.S2
unnamed: D94.A, D-ARR1.S2
unnamed: F1.2, J4.VBUS1, J4.VBUS2, R9.2
unnamed: IC1.4, IC4.3
unnamed: IC1.5, IC4.4
unnamed: IC1.14, R1.2
unnamed: IC1.15, R4.1
unnamed: IC1.16, R3.1
unnamed: IC1.17, R5.2
unnamed: IC1.19, R20.1
unnamed: IC3.12, R32.1
unnamed: IC3.14, R31.1
unnamed: IC3.16, R30.1
unnamed: IC3.17, R29.1
unnamed: IC3.19, R28.1
unnamed: IC3.20, R27.1
unnamed: IC4.33, R26.2
unnamed: J1.D+, R12.2
unnamed: J1.D-, R11.2
unnamed: J2.D+, R15.2
unnamed: J2.D-, R14.2
unnamed: J3.D+, R18.2
unnamed: J3.D-, R17.2
unnamed: J4.A5, R2.2
unnamed: J4.A6, J4.B6, R3.2
unnamed: J4.A7, J4.B7, R4.2
unnamed: J4.B5, R6.2
unnamed: LED1.K, R27.2
unnamed: LED2.K, R28.2
unnamed: LED3.K, R29.2
unnamed: LED4.K, R30.2
unnamed: LED5.K, R31.2
unnamed: LED6.K, R32.2
R1: ESC1.S1, F_1.S1, F_2.S1, F_3.S1, F_4.S1, F_5.S1, F_6.S1, F_7.S1, F_8.S1, F_9.S1, F_10.S1, F_11.S1, F_12.S1, IC4.39, PAUSE1.S1, PRINT1.S1, SCROLL1.S1
R2: -/ß1.S1, =/´1.S1, BACKSPACE1.S1, HOME1.S1, IC4.38, INSERT1.S1, UNK0.S1, UNK1.S1, UNK2.S1, UNK3.S1, UNK4.S1, UNK5.S1, UNK6.S1, UNK7.S1, UNK8.S1, UNK9.S1, UP1.S1, `/^1.S1
R3: DELETE1.S1, DOWN1.S1, E1.S1, END1.S1, I1.S1, IC4.37, O1.S1, P1.S1, Q1.S1, R34.S1, T1.S1, TAB1.S1, U1.S1, W1.S1, Z/Y1.S1, [/Ü1.S1, \\/#1.S1, ]/+1.S1
R4: ,/Ä1.S1, .1.S1, A1.S1, CAPSLOCK1.S1, D96.S1, F2.S1, G1.S1, H8.S1, IC4.36, J5.S1, K1.S1, L1.S1, RETURN1.S1, S6.S1
R5: //-1.S1, </,1.S1, <>1.S1, >/.1.S1, B1.S1, C21.S1, IC4.41, L-SHIFT1.S1, L-SHIFT2.S1, M1.S1, N1.S1, R-SHIFT1.S1, U_ARR1.S1, V1.S1, X3.S1, Y/Z1.S1
R6: D-ARR1.S1, IC4.40, L-ALT1.S1, L-CTRL1.S1, L-OS1.S1, LS1.S1, LS2.S1, L_ARR1.S1, MENU1.S1, R-ALT1.S1, R-CTRL1.S1, R-OS1.S1, RS1.S1, RS2.S1, R_ARR1.S1, SPACE1.S1
SL_LED_A: R23.1, SCROLL1.A
SL_LED_C: IC3.10, SCROLL1.K
VCC: C12.2, DISPLAY1.2, IC1.20, IC3.5, IC4.2, IC4.7, IC4.14, IC4.24, IC4.34, IC4.44, ISP1.VCC, LED1.A, LED2.A, LED3.A, LED4.A, LED5.A, LED6.A, R7.2, R9.1, R22.2, R23.2, R24.1, R25.1, R33.1
