jstein91/Apex/(commit log)

2020-07-06 Updated matrix and ground
    Updated key matrix(WIP). Replaced GND on USB hub sch with correct GND symbol.
    [Key Matrix.sch]
2020-07-06 Update matrix and MCU
    Updated matrix. Added decoupling capacitors. Added Encoder.
    [Apex rev1.sch, Key Matrix.sch]
2020-07-06 Begin annotation
    Annotated schematic and began associating symbols with footprints.
    [Apex rev1.sch, Key Matrix.sch, USB hub.sch]
2020-07-06 Assign Footprints
    Continued assigning footprints
    [Key Matrix.sch, USB hub.sch]
2020-07-07 Associate FP
    added debounce to encoder. finalized footrpint association.
    [Apex rev1.sch, Key Matrix.sch, USB hub.sch]
2020-07-07 No connects and footprints
    Added no connects and associated all footprints.
    [Apex rev1.sch]
2020-07-07 Fixed symbols
    Re-wired MCU XTAL and corrected footprints
    [Apex rev1.sch, USB hub.sch]
2020-07-07 Create Apex rev1.kicad_pcb
    [Apex rev1.kicad_pcb]
2020-07-08 switch layout
    layed out switches only
    [Apex rev1.kicad_pcb]
2020-07-08 usb layout
    [Apex rev1.kicad_pcb, Key Matrix.sch]
2020-07-08 Plane add
    added ground plane and edge cuts. refined USB placement.
    [Apex rev1.kicad_pcb]
2020-07-08 Placed Caps
    Arranged decoupling capacitors around MCU and for encoder and OLED
    [Apex rev1.kicad_pcb]
2020-07-08 Changed from hotswap to normal switch
    [Key Matrix.sch]
2020-07-08 finished switch diode placement
    [Apex rev1.kicad_pcb]
